CiTOS-Photoreactor/Circular-Photoreactor/3D Printed Parts/Control Unit/Control Unit Clamp.3mf

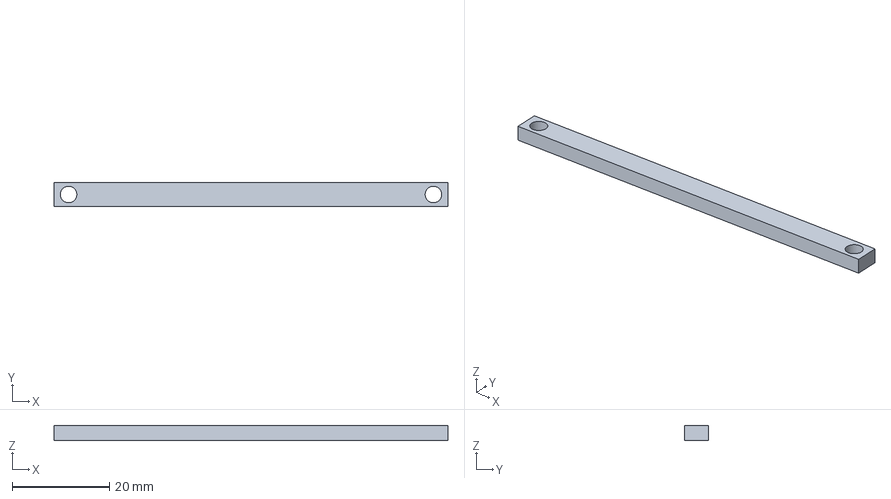
[picture p1: CAD file, 2024-03-26]
3D Printed Parts/Control Unit/Control Unit Clamp.3mf
81.2 x 5.00 x 3.00 mm
