CiTOS-Photoreactor/Circular-Photoreactor/3D Printed Parts/LED Holder/Frame.3mf

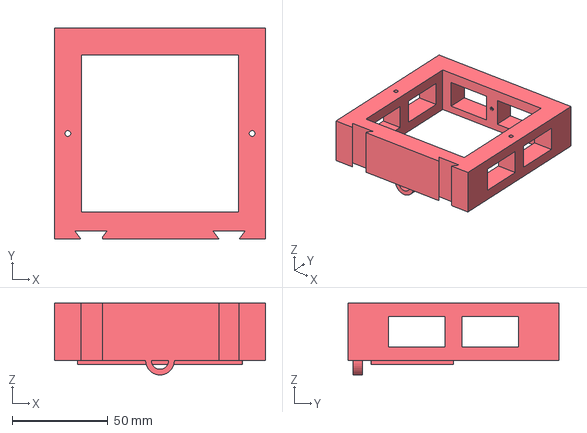
[picture p2: CAD file, 2024-03-26]
3D Printed Parts/LED Holder/Frame.3mf
110.0 x 110.0 x 37.5 mm
