CiTOS-Photoreactor/Circular-Photoreactor/3D Printed Parts/LEDs Power Supply/LED PS Top n Clamp.3mf

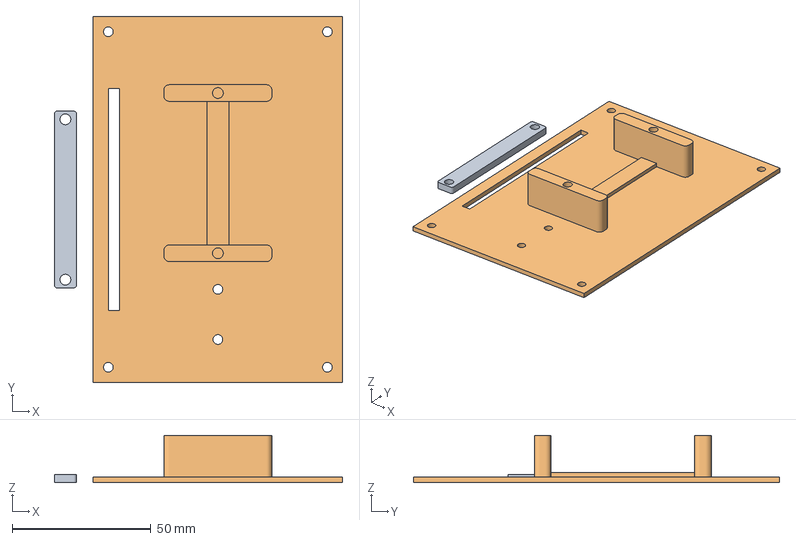
[picture p3: CAD file, 2024-03-26]
3D Printed Parts/LEDs Power Supply/LED PS Top n Clamp.3mf
104.0 x 132.0 x 17.0 mm
LED CU Clamp
LED CU Top
