CiTOS-Photoreactor/Circular-Photoreactor/3D Printed Parts/Photoreactor/Lid Top.3mf

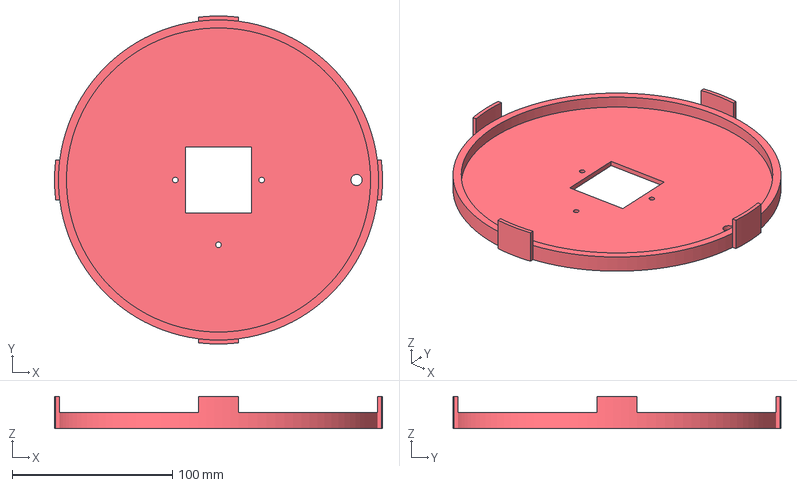
[picture p4: CAD file, 2024-03-26]
3D Printed Parts/Photoreactor/Lid Top.3mf
204.9 x 204.9 x 20.0 mm
