CiTOS-Photoreactor/Circular-Photoreactor/KiCAD custom PCB/PPR.step

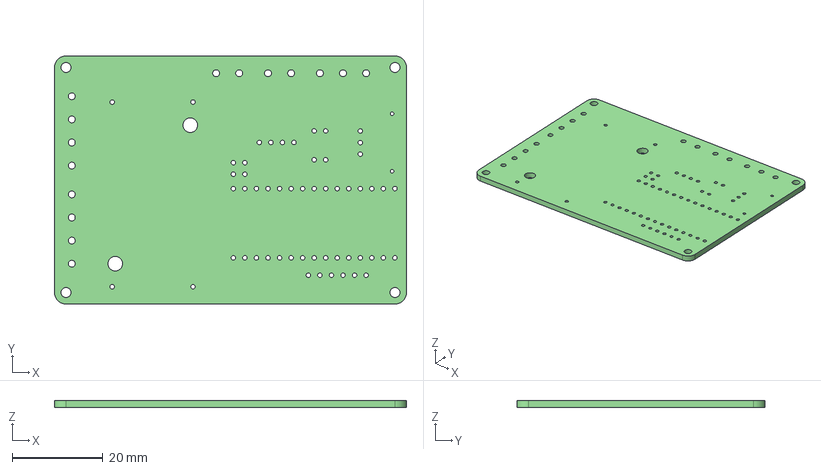
[picture p5: CAD file, 2024-03-26]
KiCAD custom PCB/PPR.step
77.5 x 54.6 x 1.60 mm
