CiTOS-Photoreactor/Circular-Photoreactor/3D Printed Parts/Control Unit/Control Unit Back Panel.3mf

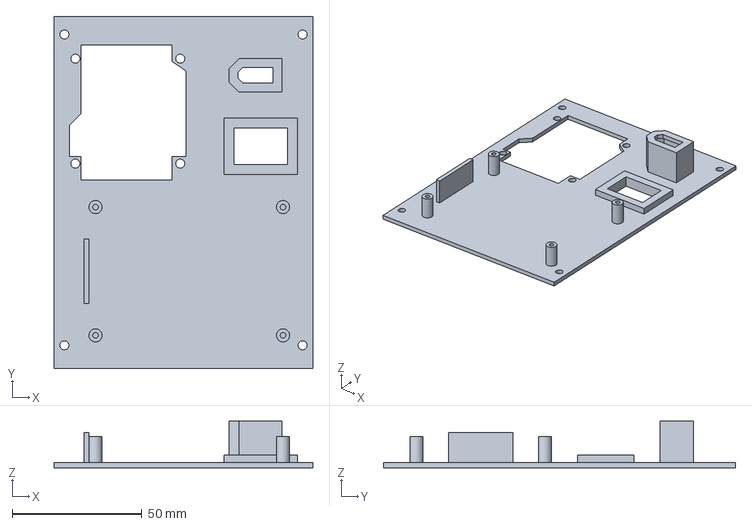
[picture p6: CAD file, 2024-03-26]
3D Printed Parts/Control Unit/Control Unit Back Panel.3mf
100.0 x 136.0 x 18.0 mm
