CiTOS-Photoreactor/Circular-Photoreactor/3D Printed Parts/LED Holder/Plate.3mf

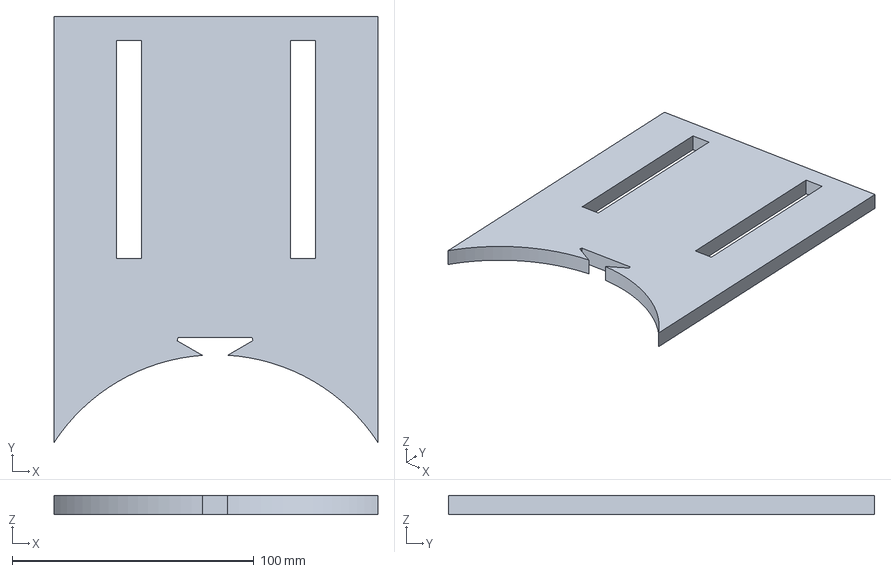
[picture p7: CAD file, 2024-03-26]
3D Printed Parts/LED Holder/Plate.3mf
134.0 x 176.3 x 8.00 mm
