CiTOS-Photoreactor/Circular-Photoreactor/3D Printed Parts/LEDs Power Supply/LED PS Back Panel.3mf

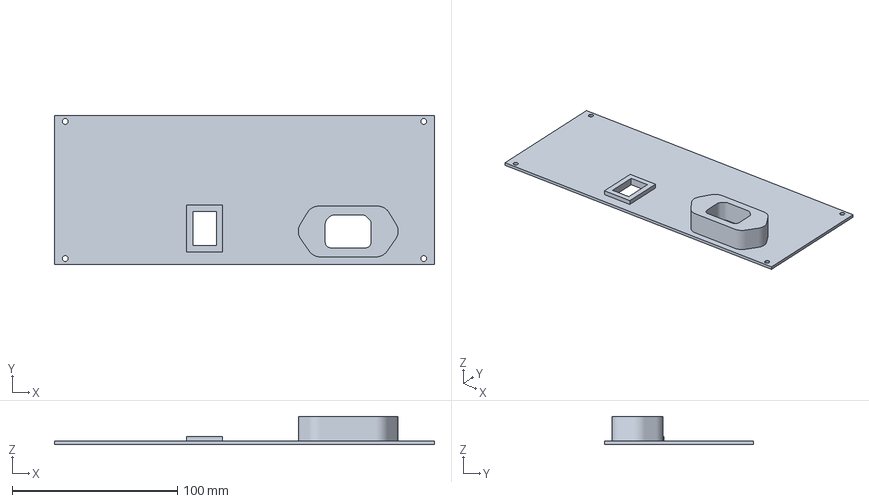
[picture p8: CAD file, 2024-03-26]
3D Printed Parts/LEDs Power Supply/LED PS Back Panel.3mf
230.0 x 90.0 x 17.0 mm
