CiTOS-Photoreactor/Circular-Photoreactor/3D Printed Parts/Photoreactor/PPR Foot.3mf

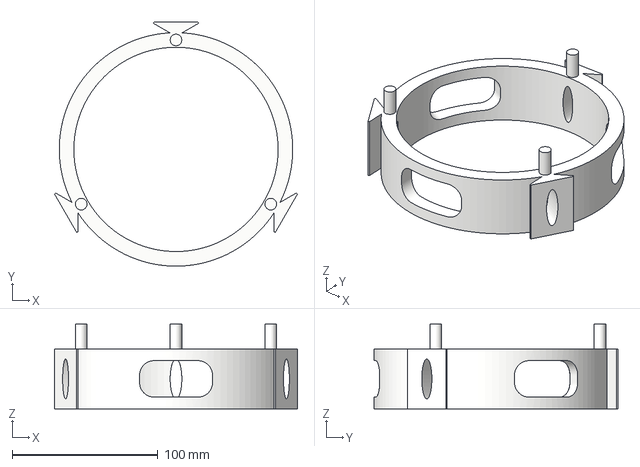
[picture p9: CAD file, 2024-03-26]
3D Printed Parts/Photoreactor/PPR Foot.3mf
166.5 x 167.4 x 58.0 mm
