CiTOS-Photoreactor/Circular-Photoreactor/3D Printed Parts/Control Unit/Control Unit Frame.3mf

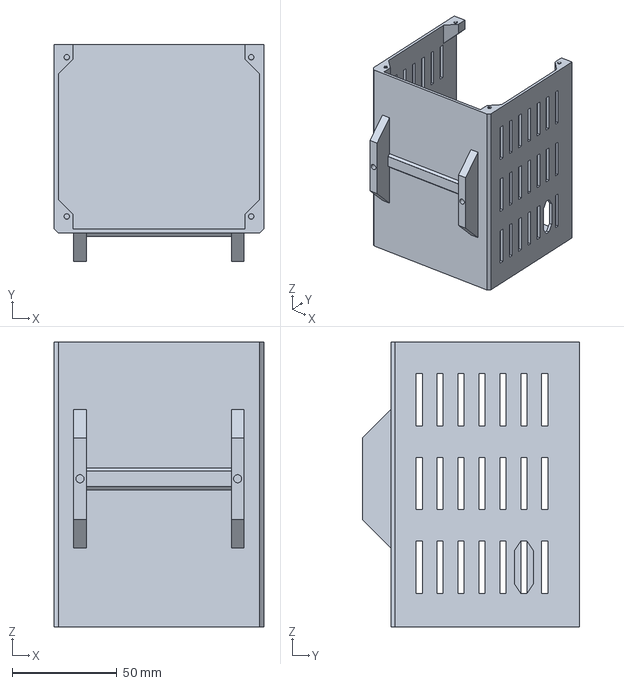
[picture p10: CAD file, 2024-03-26]
3D Printed Parts/Control Unit/Control Unit Frame.3mf
100.0 x 103.5 x 136.0 mm
