CiTOS-Photoreactor/Circular-Photoreactor/3D Printed Parts/LED Holder/Foot.3mf

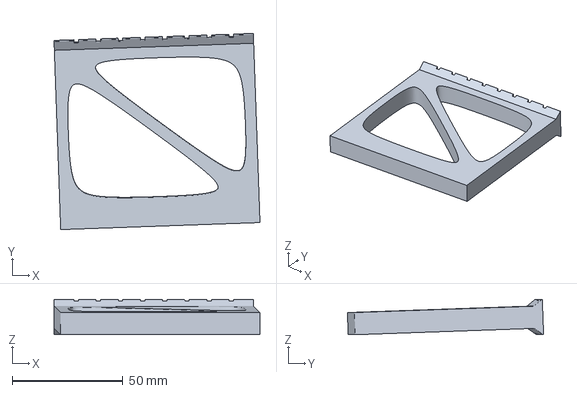
[picture p11: CAD file, 2024-03-26]
3D Printed Parts/LED Holder/Foot.3mf
93.0 x 88.5 x 16.0 mm
