CiTOS-Photoreactor/Circular-Photoreactor/3D Printed Parts/LEDs Power Supply/LED PS Frame.3mf

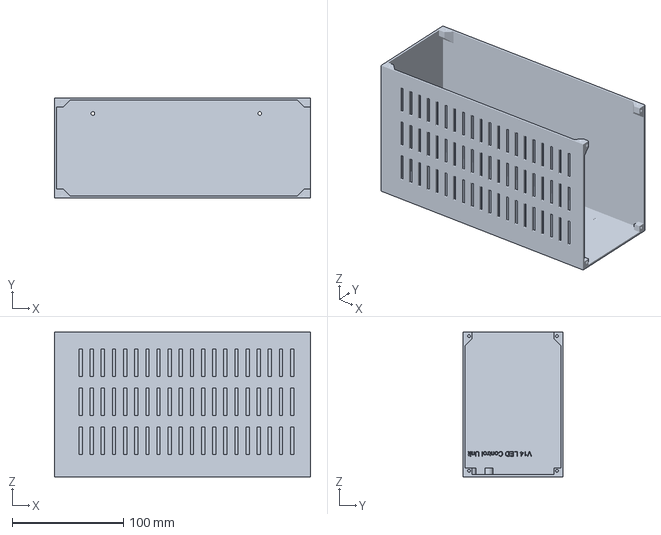
[picture p12: CAD file, 2024-03-26]
3D Printed Parts/LEDs Power Supply/LED PS Frame.3mf
230.0 x 90.0 x 130.0 mm
