CiTOS-Photoreactor/Circular-Photoreactor/3D Printed Parts/Photoreactor/Clamp outside.3mf

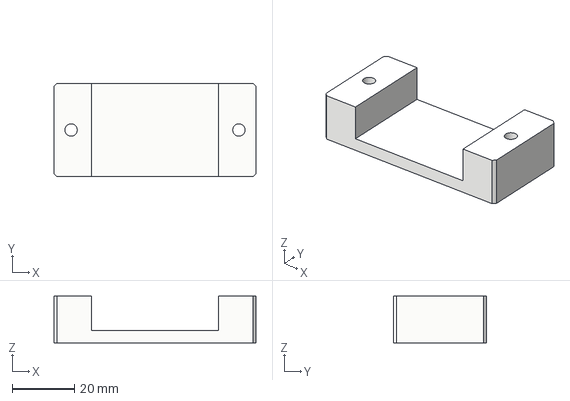
[picture p13: CAD file, 2024-03-26]
3D Printed Parts/Photoreactor/Clamp outside.3mf
65.0 x 30.0 x 15.0 mm
