CiTOS-Photoreactor/Circular-Photoreactor/3D Printed Parts/Control Unit/Control Unit Top.3mf

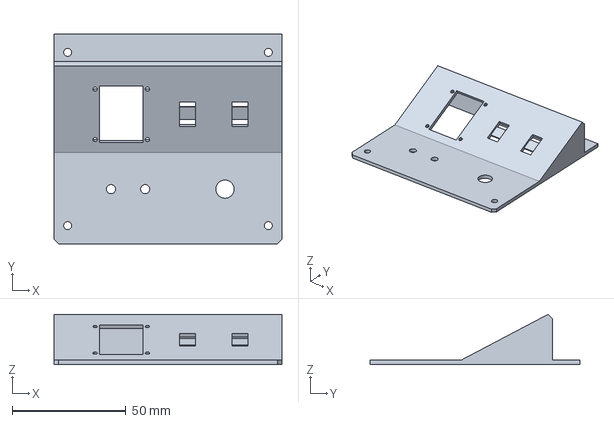
[picture p14: CAD file, 2024-03-26]
3D Printed Parts/Control Unit/Control Unit Top.3mf
100.0 x 92.0 x 22.0 mm
