CiTOS-Photoreactor/Circular-Photoreactor/3D Printed Parts/Photoreactor/PPR Frame.3mf

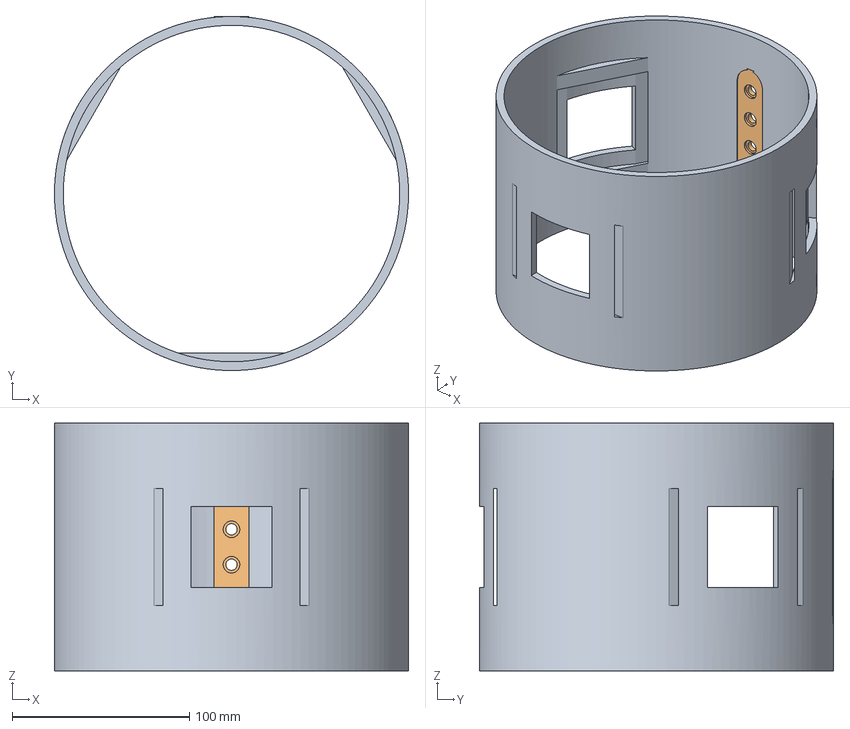
[picture p15: CAD file, 2024-03-26]
3D Printed Parts/Photoreactor/PPR Frame.3mf
200.0 x 200.0 x 140.0 mm
UnionsSlot
