CiTOS-Photoreactor/Circular-Photoreactor/3D Printed Parts/Photoreactor/Lid Bottom.3mf

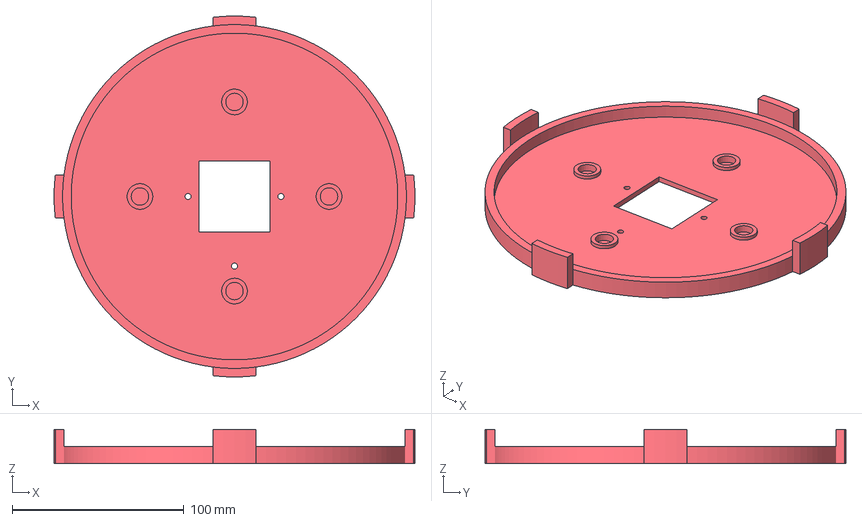
[picture p16: CAD file, 2024-03-26]
3D Printed Parts/Photoreactor/Lid Bottom.3mf
210.0 x 210.0 x 20.0 mm
