CiTOS-Photoreactor/Circular-Photoreactor/3D Printed Parts/Photoreactor/Clamp inside.3mf

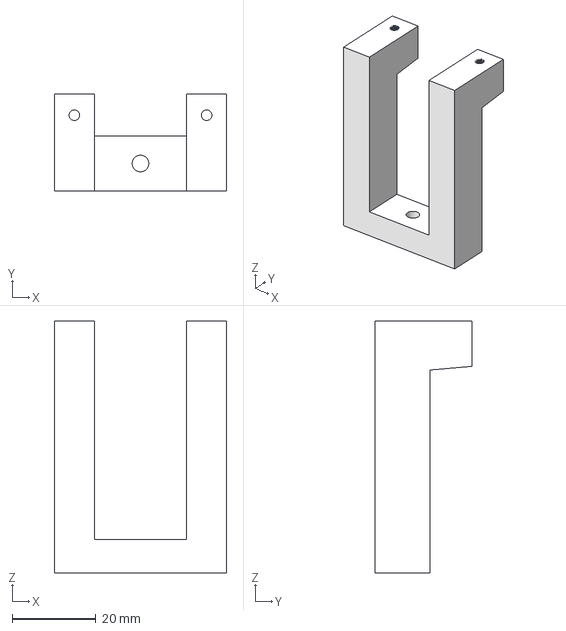
[picture p17: CAD file, 2024-03-26]
3D Printed Parts/Photoreactor/Clamp inside.3mf
41.0 x 23.0 x 60.0 mm
