CiTOS-Photoreactor/Circular-Photoreactor/3D Printed Parts/Photoreactor/Reactor support.3mf

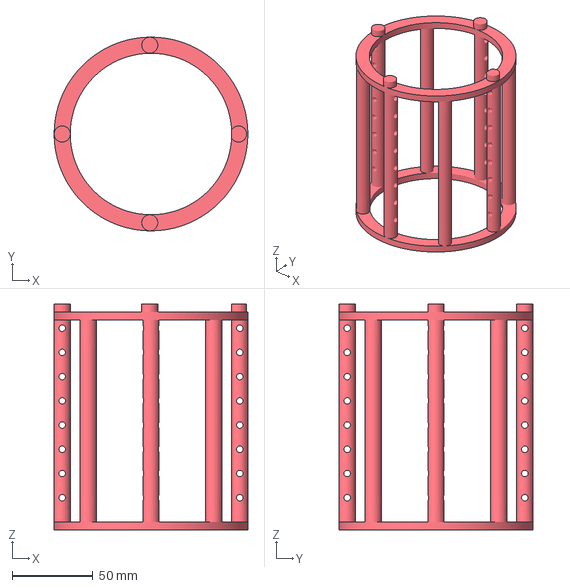
[picture p18: CAD file, 2024-03-26]
3D Printed Parts/Photoreactor/Reactor support.3mf
120.0 x 120.0 x 140.0 mm
