CiTOS-Photoreactor/Circular-Photoreactor/3D Printed Parts/LED Holder/LED Holder L Drawing.pdf

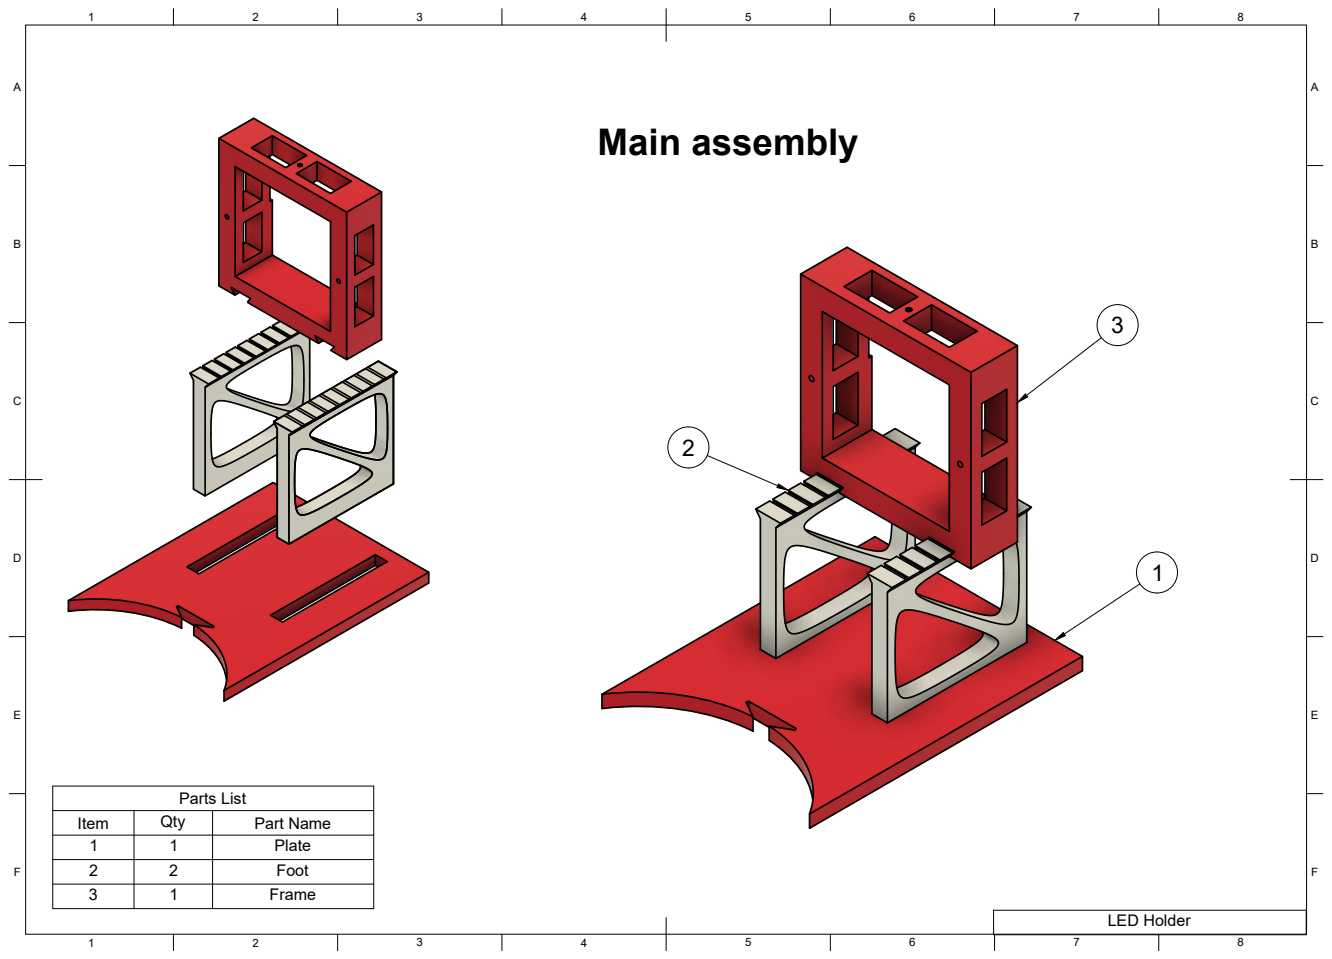
[picture p19: page 1]
Parts List; LED Holder; Main assembly

Item | Qty | Part Name
1 | 1 | Plate
2 | 2 | Foot
3 | 1 | Frame
