CiTOS-Photoreactor/Circular-Photoreactor/3D Printed Parts/Photoreactor/Assembled_PPR_L Drawing.pdf

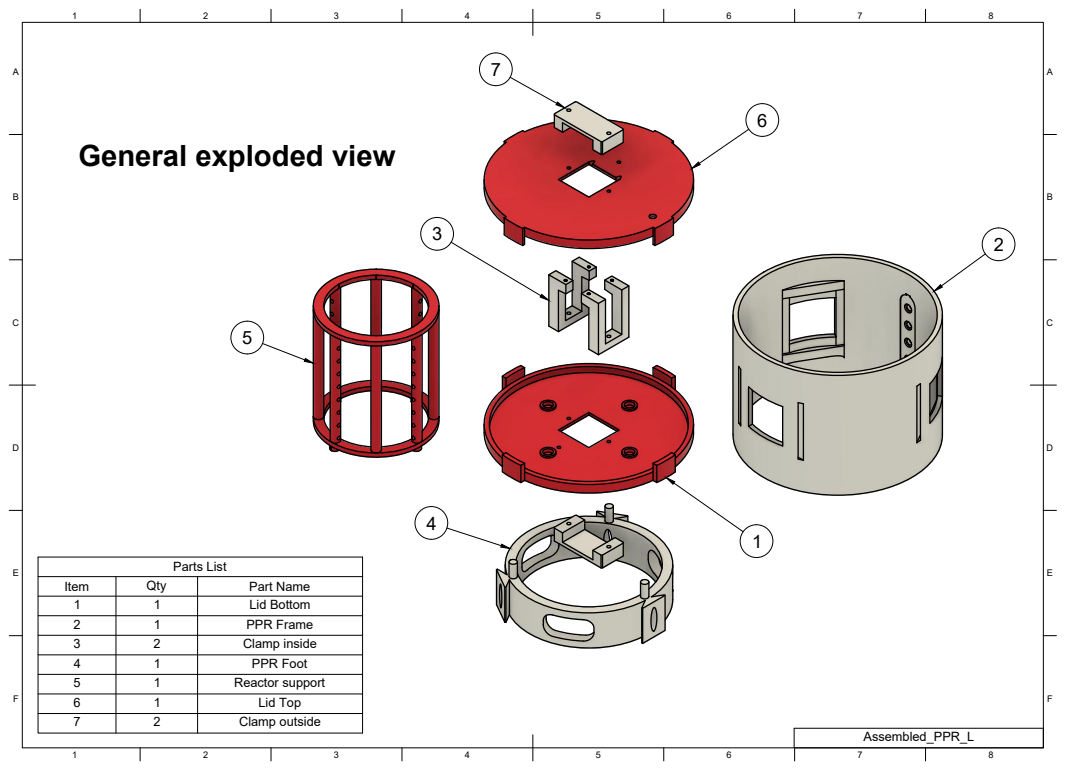
[picture p20: page 1]
Parts List

General exploded view

Item | Qty | Part Name
1 | 1 | Lid Bottom
2 | 1 | PPR Frame
3 | 2 | Clamp inside
4 | 1 | PPR Foot
5 | 1 | Reactor support
6 | 1 | Lid Top
7 | 2 | Clamp outside

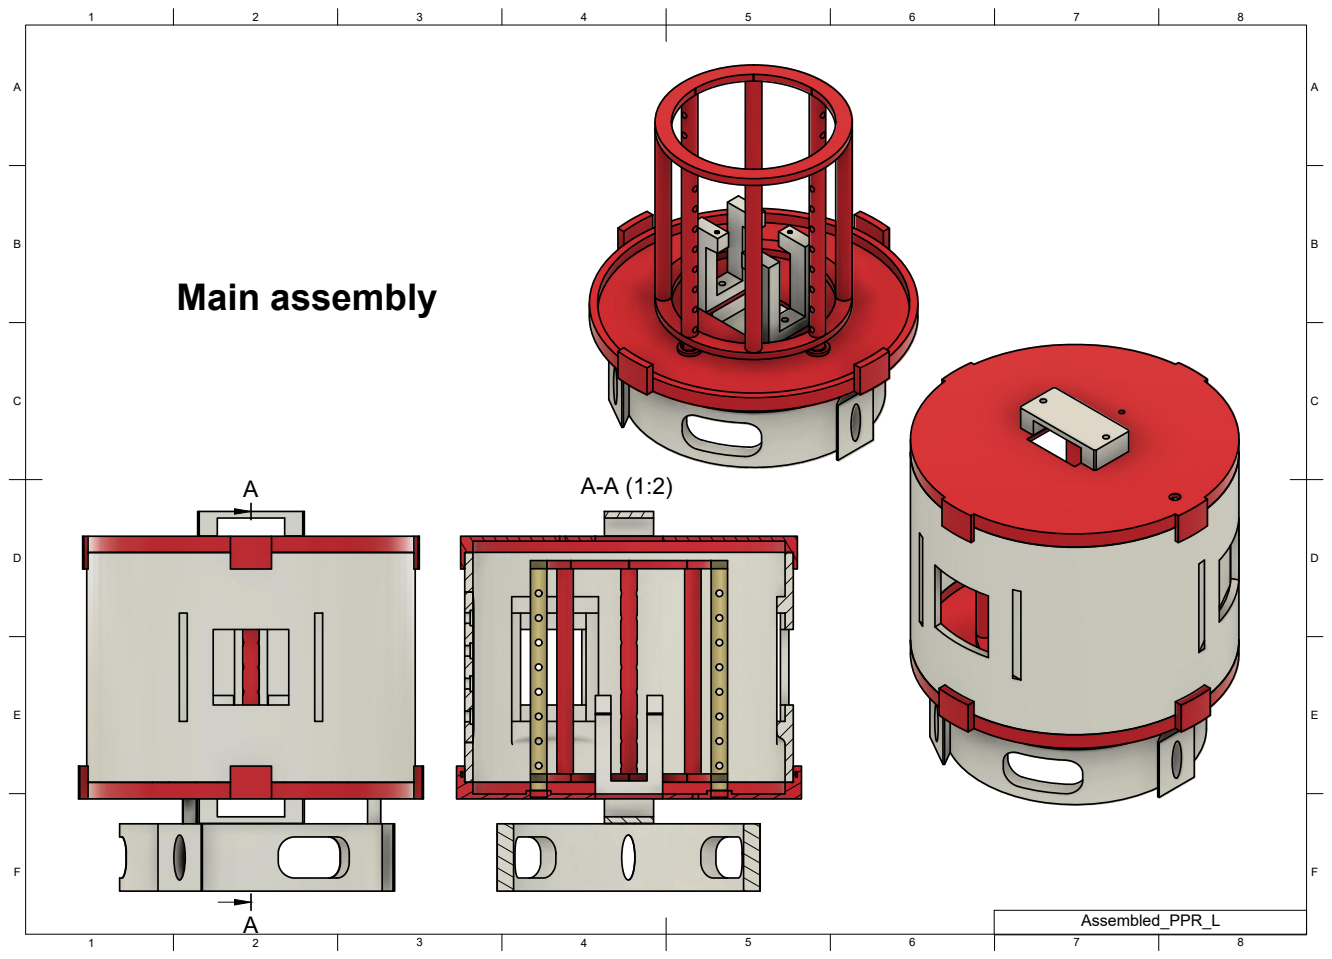
[picture p21: page 2]
Main assembly
