CiTOS-Photoreactor/Circular-Photoreactor/KiCAD custom PCB/PPR.kicad_pcb

## KiCad design KiCAD custom PCB/PPR.kicad_pcb (2024-03-26)

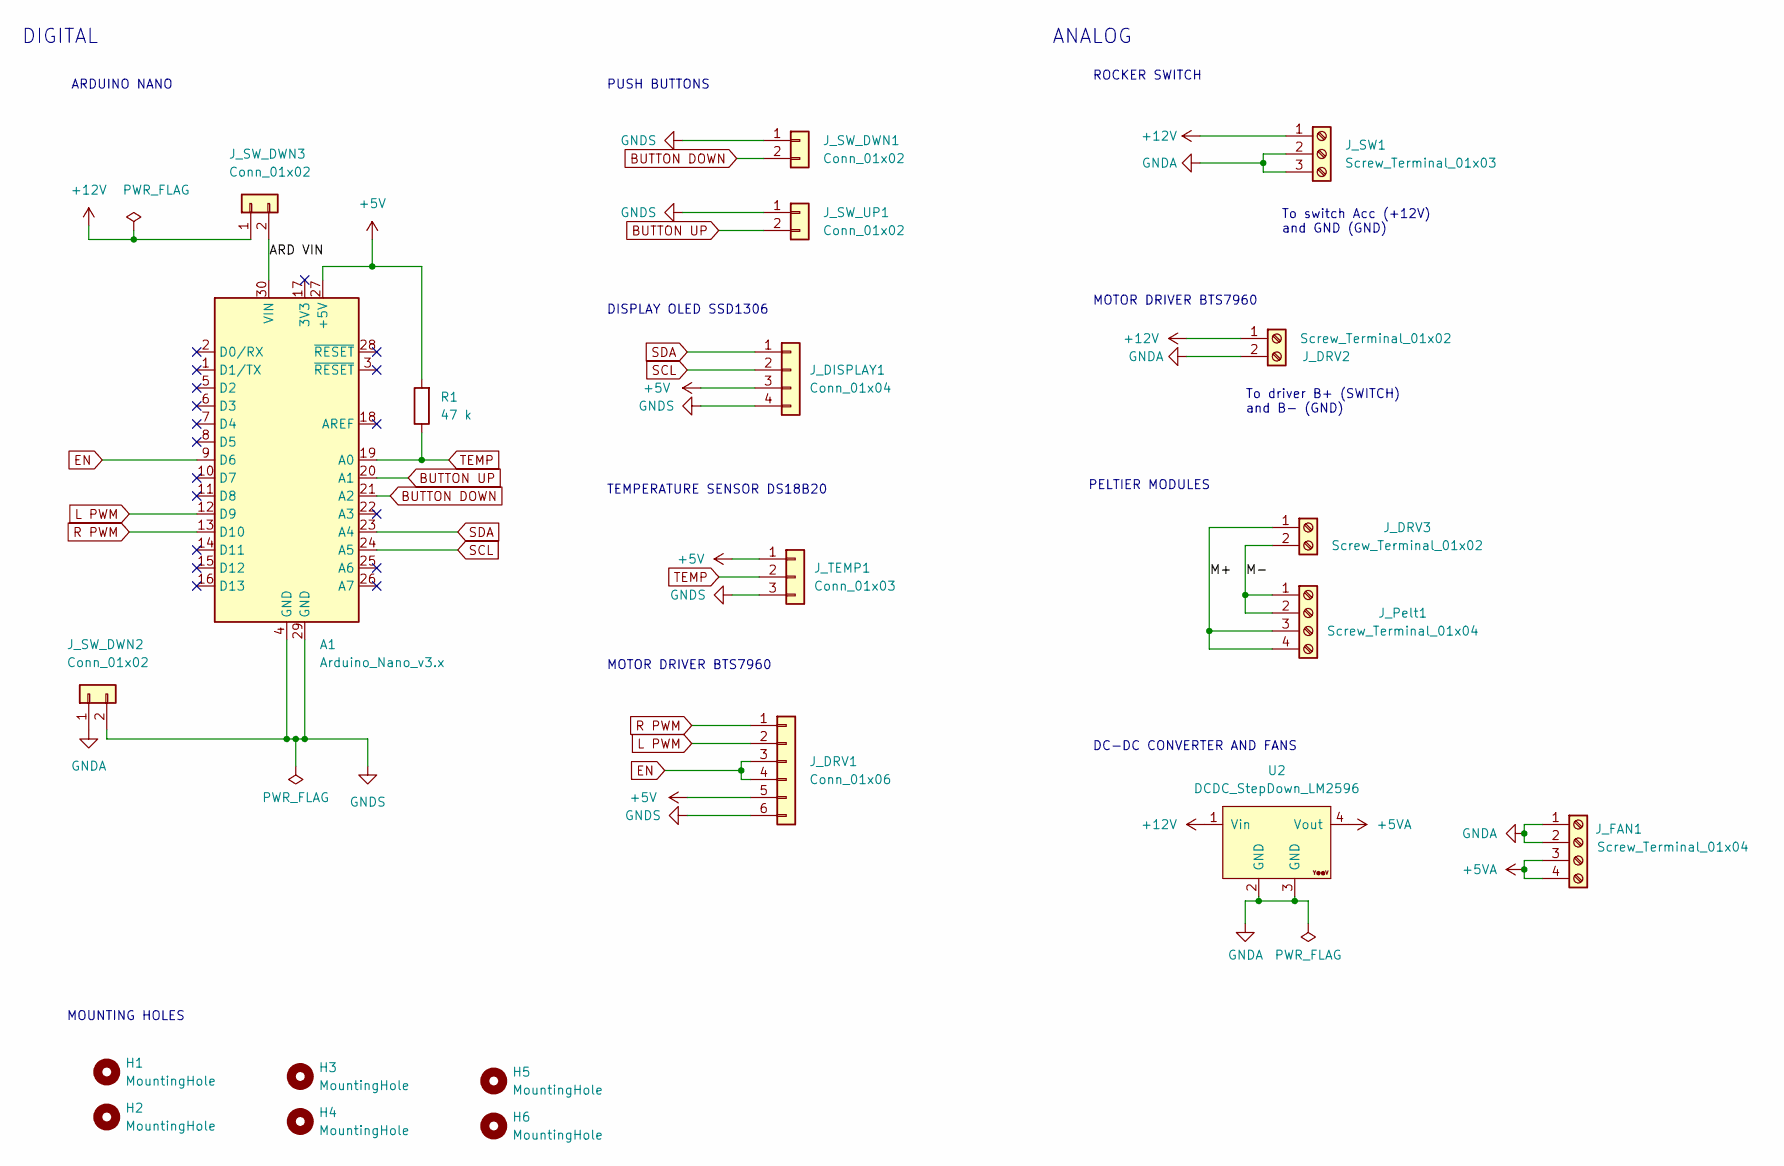
[picture p22: schematic PPR.kicad_sch]

Parts:
A1: Arduino_Nano_v3.x; Arduino_Nano
H1, H2, H3, H4: MountingHole; MountingHole_2.2mm_M2
H5, H6: MountingHole; MountingHole_3.2mm_M3
J_DISPLAY1: Conn_01x04; PinHeader_1x04_P2.54mm_Vertical
J_DRV1: Conn_01x06; PinHeader_1x06_P2.54mm_Vertical
J_DRV2, J_DRV3: Screw_Terminal_01x02; TerminalBlock_bornier-2_P5.08mm
J_FAN1: Screw_Terminal_01x04; TerminalBlock_bornier-4_P5.08mm
J_Pelt1: Screw_Terminal_01x04; TerminalBlock_bornier-4_P5.08mm
J_SW1: Screw_Terminal_01x03; TerminalBlock_bornier-3_P5.08mm
J_SW_DWN1, J_SW_DWN2, J_SW_DWN3: Conn_01x02; PinHeader_1x02_P2.54mm_Vertical
J_SW_UP1: Conn_01x02; PinHeader_1x02_P2.54mm_Vertical
J_TEMP1: Conn_01x03; PinHeader_1x03_P2.54mm_Vertical
R1: 47 k; R_Axial_DIN0309_L9.0mm_D3.2mm_P12.70mm_Horizontal
U2: DCDC_StepDown_LM2596; YAAJ_DCDC_StepDown_LM2596

Connections:
+5V: A1.27 (+5V), J_DISPLAY1.3, J_DRV1.5, J_TEMP1.1, R1.2
+5VA: J_FAN1.3, J_FAN1.4, U2.4 (Vout)
+12V: J_DRV2.1, J_SW1.1, J_SW_DWN3.1, U2.1 (Vin)
/ARD VIN: A1.30 (VIN), J_SW_DWN3.2
/M+: J_DRV3.1, J_Pelt1.3, J_Pelt1.4
/M-: J_DRV3.2, J_Pelt1.1, J_Pelt1.2
BUTTON DOWN: A1.21 (A2), J_SW_DWN1.2
BUTTON UP: A1.20 (A1), J_SW_UP1.2
EN: A1.9 (D6), J_DRV1.3, J_DRV1.4
GNDA: J_DRV2.2, J_FAN1.1, J_FAN1.2, J_SW1.2, J_SW1.3, J_SW_DWN2.1, U2.2 (GND), U2.3 (GND)
GNDS: A1.4 (GND), A1.29 (GND), J_DISPLAY1.4, J_DRV1.6, J_SW_DWN1.1, J_SW_DWN2.2, J_SW_UP1.1, J_TEMP1.3
L PWM: A1.12 (D9), J_DRV1.2
R PWM: A1.13 (D10), J_DRV1.1
SCL: A1.24 (A5), J_DISPLAY1.2
SDA: A1.23 (A4), J_DISPLAY1.1
TEMP: A1.19 (A0), J_TEMP1.2, R1.1

Notes on the sheet:
To switch Acc (+12V) and GND (GND)
ROCKER SWITCH
DISPLAY OLED SSD1306
MOUNTING HOLES
TEMPERATURE SENSOR DS18B20
PELTIER MODULES
DIGITAL
ARDUINO NANO
DC-DC CONVERTER AND FANS
PUSH BUTTONS
ANALOG
To driver B+ (SWITCH) and B- (GND)
MOTOR DRIVER BTS7960

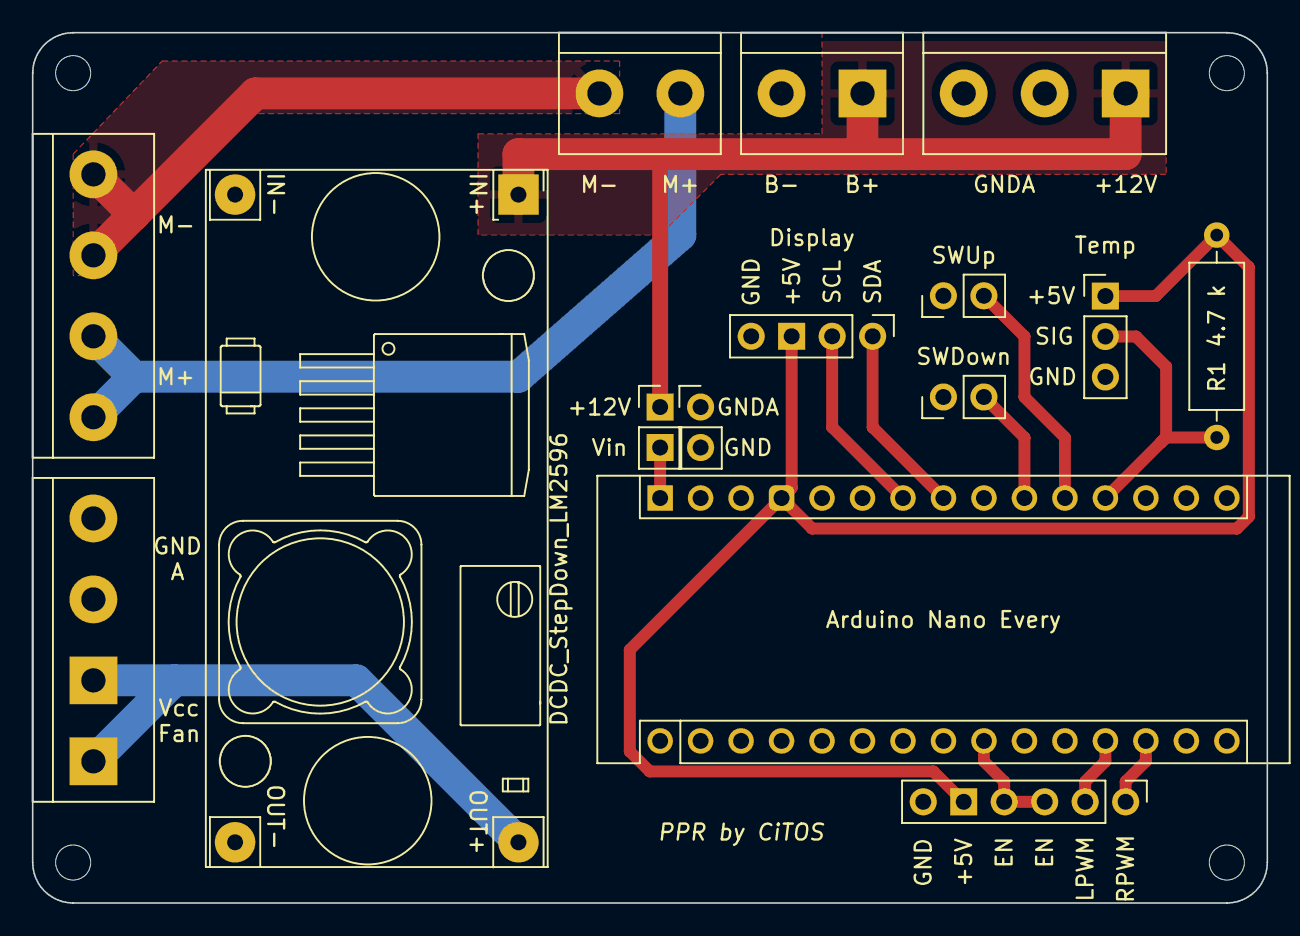
[picture p23: board PPR.kicad_pcb from above]

Board: 2 copper layers, 77.5 x 54.6 mm, 21 parts (0 on the bottom side), 16 nets.
